c2674321678/auto_ball_picker/Docs/自动寻球小车实物图.png

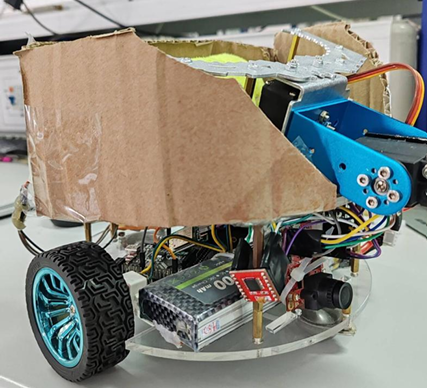
Docs/自动寻球小车实物图.png
