c2674321678/auto_ball_picker/Docs/OpenMv硬件连接图.png

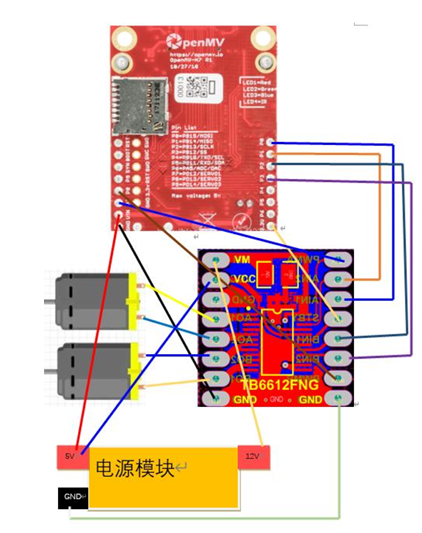
Docs/OpenMv硬件连接图.png
